owhite/balance_bot/docs/board.png

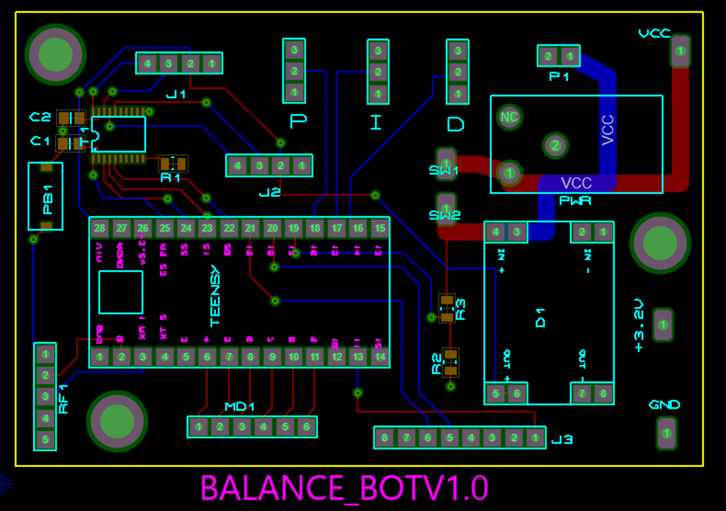
docs/board.png
