owhite/balance_bot/docs/LM298n.jpg

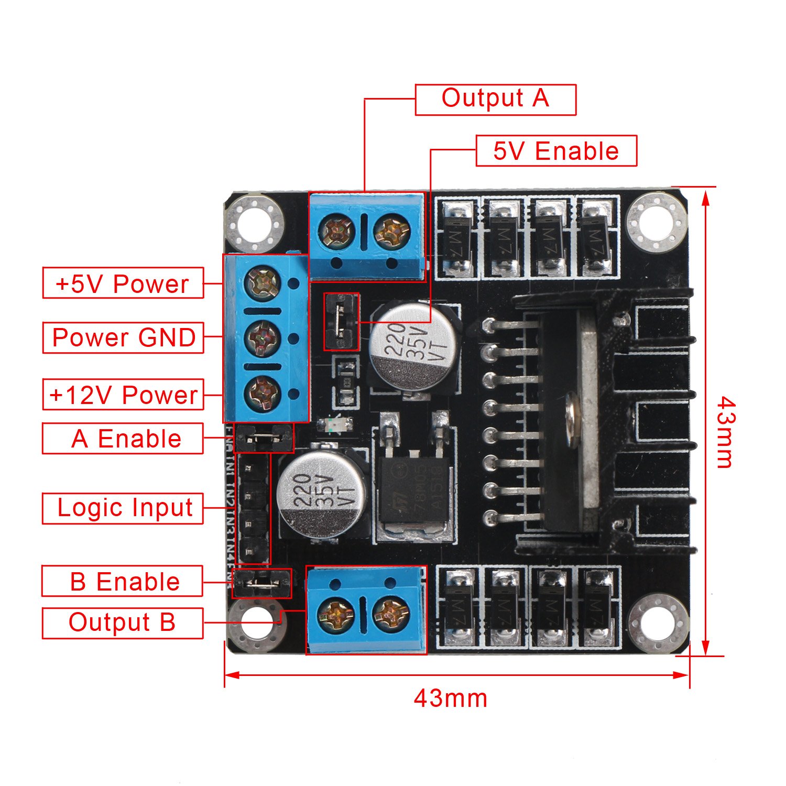
docs/LM298n.jpg
