owhite/balance_bot/docs/circuit.PDF

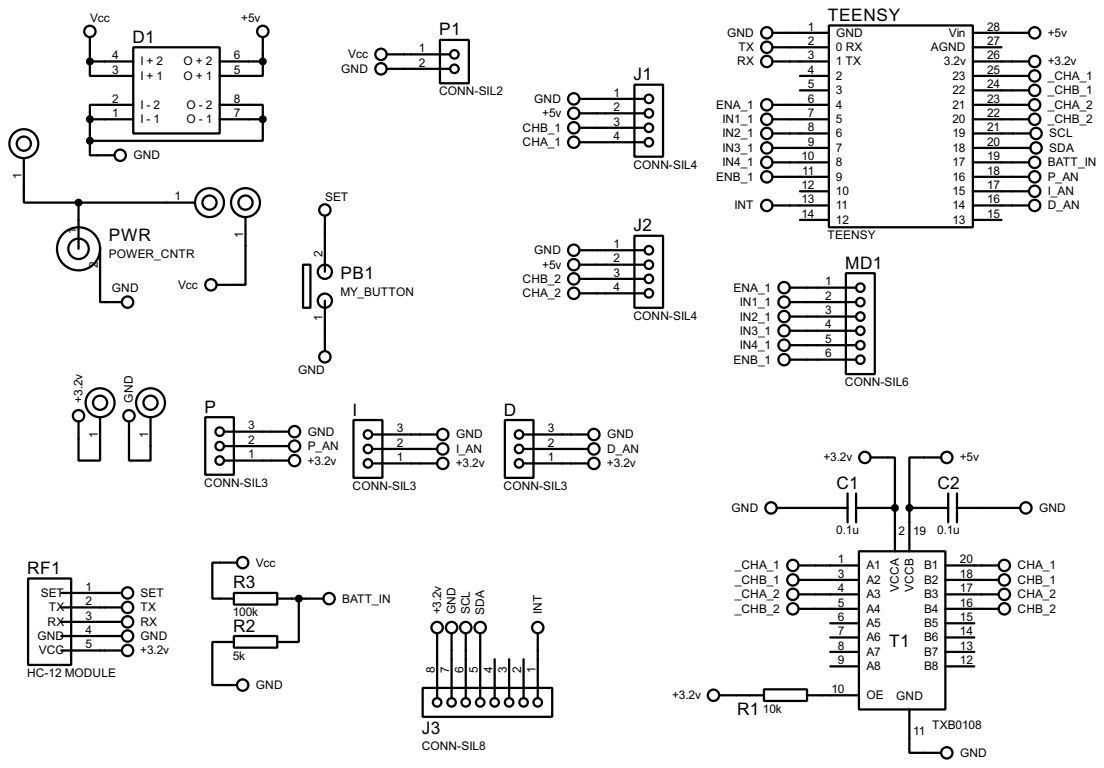
[picture p6: page 1]
