owhite/balance_bot/docs/balance_board.PDF

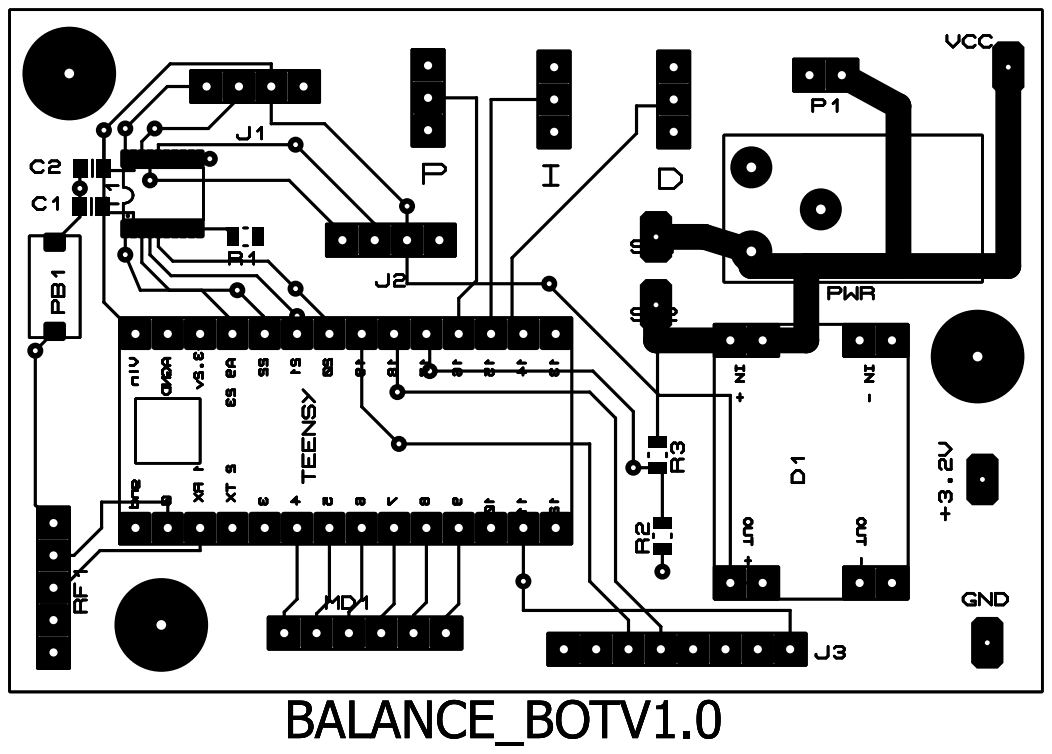
[picture p7: page 1]
