owhite/balance_bot/shared_lib/icon_data.h

#define ICON_HEIGHT 64
#define ICON_WIDTH  128

#define ICON_MAX    5

static uint8_t PROGMEM const icon_bmp[][4096] = {
{
 B11011000, B00000001, B00011111, B11111111, B10011000, B00000011, B00000110, B00100000, B00000000, B00000000, B00000000, B00000000, B00000000, B00000000, B00000000, B00000001,
 B11111111, B11111111, B11111111, B11111110, B10001001, B10000000, B00000001, B11101111, B01111110, B11000000, B10000000, B00000000, B00000000, B00000000, B00001000, B00111000,
 B11000000, B11100000, B00000000, B00000000, B01100000, B00001111, B10000000, B00000100, B00000000, B00000000, B00000000, B00000000, B10000000, B00010000, B11100110, B00001100,
 B11000000, B00000000, B00000000, B00000000, B00000000, B00000010, B11000000, B00000000, B00000000, B00000000, B00000000, B00000000, B00000000, B00000011, B10000000, B00000000,
 B01100000, B00001100, B00000000, B00000000, B00000000, B00000001, B01111000, B00000000, B00000000, B00000000, B00000000, B00000000, B00000000, B00011110, B00000000, B00000100,
 B01100000, B00000011, B11100000, B00010000, B00000000, B00000000, B10011110, B00000000, B00000000, B00000000, B00000000, B00000000, B00000000, B11111100, B00000000, B00000100,
 B00100000, B00000011, B10000000, B00000110, B00000000, B00000000, B00100011, B11000000, B00000000, B00000000, B00000000, B00000000, B00001111, B10000110, B00000000, B00000100,
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
 B00000000, B00000000, B01111111, B11100000, B00011111, B11100111, B11111111, B11111111, B11111111, B11111111, B11111111, B11111111, B11111111, B11111111, B11100000, B00000000,
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
}
};
