owhite/balance_bot/shared_lib/infinity_data.h

#define INFINITY_WIDTH 64
#define INFINITY_HEIGHT 46
#define INFINITY_MAX 24

static uint8_t PROGMEM const infinity_gif[][2944] = {
 { // frame 0
 B00000000, B00000000, B00000000, B00000000, B00000000, B00000000, B00000000, B00000000,
 B00000000, B00000000, B00000000, B00000000, B00000000, B00000000, B00000000, B00000000,
 B00000000, B00000000, B00000000, B00000000, B00000000, B00000000, B00000000, B00000000,
 B00000000, B00000000, B00000000, B00000000, B00000000, B00000000, B00000000, B00000000,
 B00000000, B00001111, B11100000, B00000000, B00000000, B00000000, B00000000, B00000000,
 B00000000, B00111111, B11111000, B00000000, B00000000, B00000000, B00000000, B00000000,
 B00000000, B01111111, B11111100, B00000000, B00000000, B00000000, B00000000, B00000000,
 B00000000, B11111111, B11111110, B00000000, B00000000, B00000000, B00000000, B00000000,
 B00000001, B11111110, B01111111, B00000000, B00000000, B00000000, B00000000, B00000000,
 B00000001, B11111100, B00011111, B10000000, B00000000, B00000000, B00000000, B00000000,
 B00000011, B11111000, B00000111, B11000000, B00000000, B00000000, B00000000, B00000000,
 B00000011, B11110000, B00000011, B11100000, B00000000, B00000000, B00000000, B00000000,
 B00000111, B11110000, B00000001, B11100000, B00000000, B00000000, B00000000, B00000000,
 B00000111, B11100000, B00000000, B11110000, B00000000, B00000000, B00000000, B00000000,
 B00001111, B11100000, B00000000, B01111000, B00000000, B00000000, B00000000, B00000000,
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
 B00000011, B11111111, B11111111, B11110000, B00000000, B00111000, B00000000, B00000000,
 B00000011, B11111111, B11111111, B11100000, B00000000, B00011100, B00000000, B00000000,
 B00000001, B11111111, B11111111, B11000000, B00000000, B00000111, B00000000, B00000000,
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
 }
}; // end infinity_gif
